bcagnoni/BlueBus/(commit log)

2020-11-24 [IMP] hardware: v1.1.6 * Re-wire BC127 power input for use with fixed regulated voltage, rather than battery power
    [BlueBus.brd, BlueBus.sch]
2020-12-05 [IMP] firmware: Application Localization Support
    * Extended ASCII symbols support fix.
    * Device name normalization fixed.
    * UtilsNormalizeText method refactoring.
    * Friendly device name size increased.
    * Defines wording update.
    * Utils char maping table updated according russified BMW Navigation firmware.
    * Exclude not used chars and no-break space char from the supported ranged.
    * Cyrillic chars support for russified BMW navigation firmware.
    * Russian localization added.
    * Additional unicode characters support added.
    * Settings UI menu refresh on language selection.
    [bmbt.c, bmbt.h, mappings.h, mid.c]
2020-12-05 [IMP] firmware: Application Localization Improvements * Rename `local` to `locale` * Alphabetize `locale` in build scripts * Remove Apply option for Language in favor of keeping all languages in the 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
    [bmbt.c, bmbt.h]
2020-12-05 [IMP] firmware: Application pre-1.1.17 improvements * Support Digital audio for calls when coax cable is used * Clean up telephony volume handling code * Set max volume offset to 12 steps * Add BLE/M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
    [bmbt.c]
2020-12-05 [IMP] firmware: Application Updates * Drop in German i18n * Begin support for Español * Fix Caller ID issues for multi-word callers * Improve i18n code
    [bmbt.c]
2020-12-05 [IMP] firmware: application * Condense `Lang` selection code and fix issues with language display * Remove `Apply` from Russian language array
    [bmbt.c]
2020-12-05 [IMP] firmware: Bootloader v1.5 * Alter code so flash space up to 0xABEFF is erased when we query the device to erase flash
2020-12-05 [IMP] firmware: Application 1.1.17 * I18n improvements * Catch for BC127 boot failure. Red TEL LED is now blinked to signify a fault * Added Config "Values" rather than "Settings" * Fix "Main Menu" S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
    [bmbt.c, cd53.c, cli.c]
2020-12-09 [IMP] hardware: v1.6: Minor updates * Re-add 10k resistors to BC127 UART lines * Minor rewiring work around the TMUX154
    [BlueBus.brd, BlueBus.sch]
2020-12-11 [IMP] harware: v1.5 updates * Replace L2 with MPL-SE5040-100 as other part is OOS * Replace C12 and C13 with 22uF capacitors * Replace 22uF capacitor part with one rated for 16v
    [BlueBus.brd, BlueBus.sch]
